davidpalma666/device.outputexpander-Fork/Hardware/PCB/output expander/harp expander output.kicad_pcb

## KiCad design Hardware/PCB/output expander/harp expander output.kicad_pcb (2026-06-30)

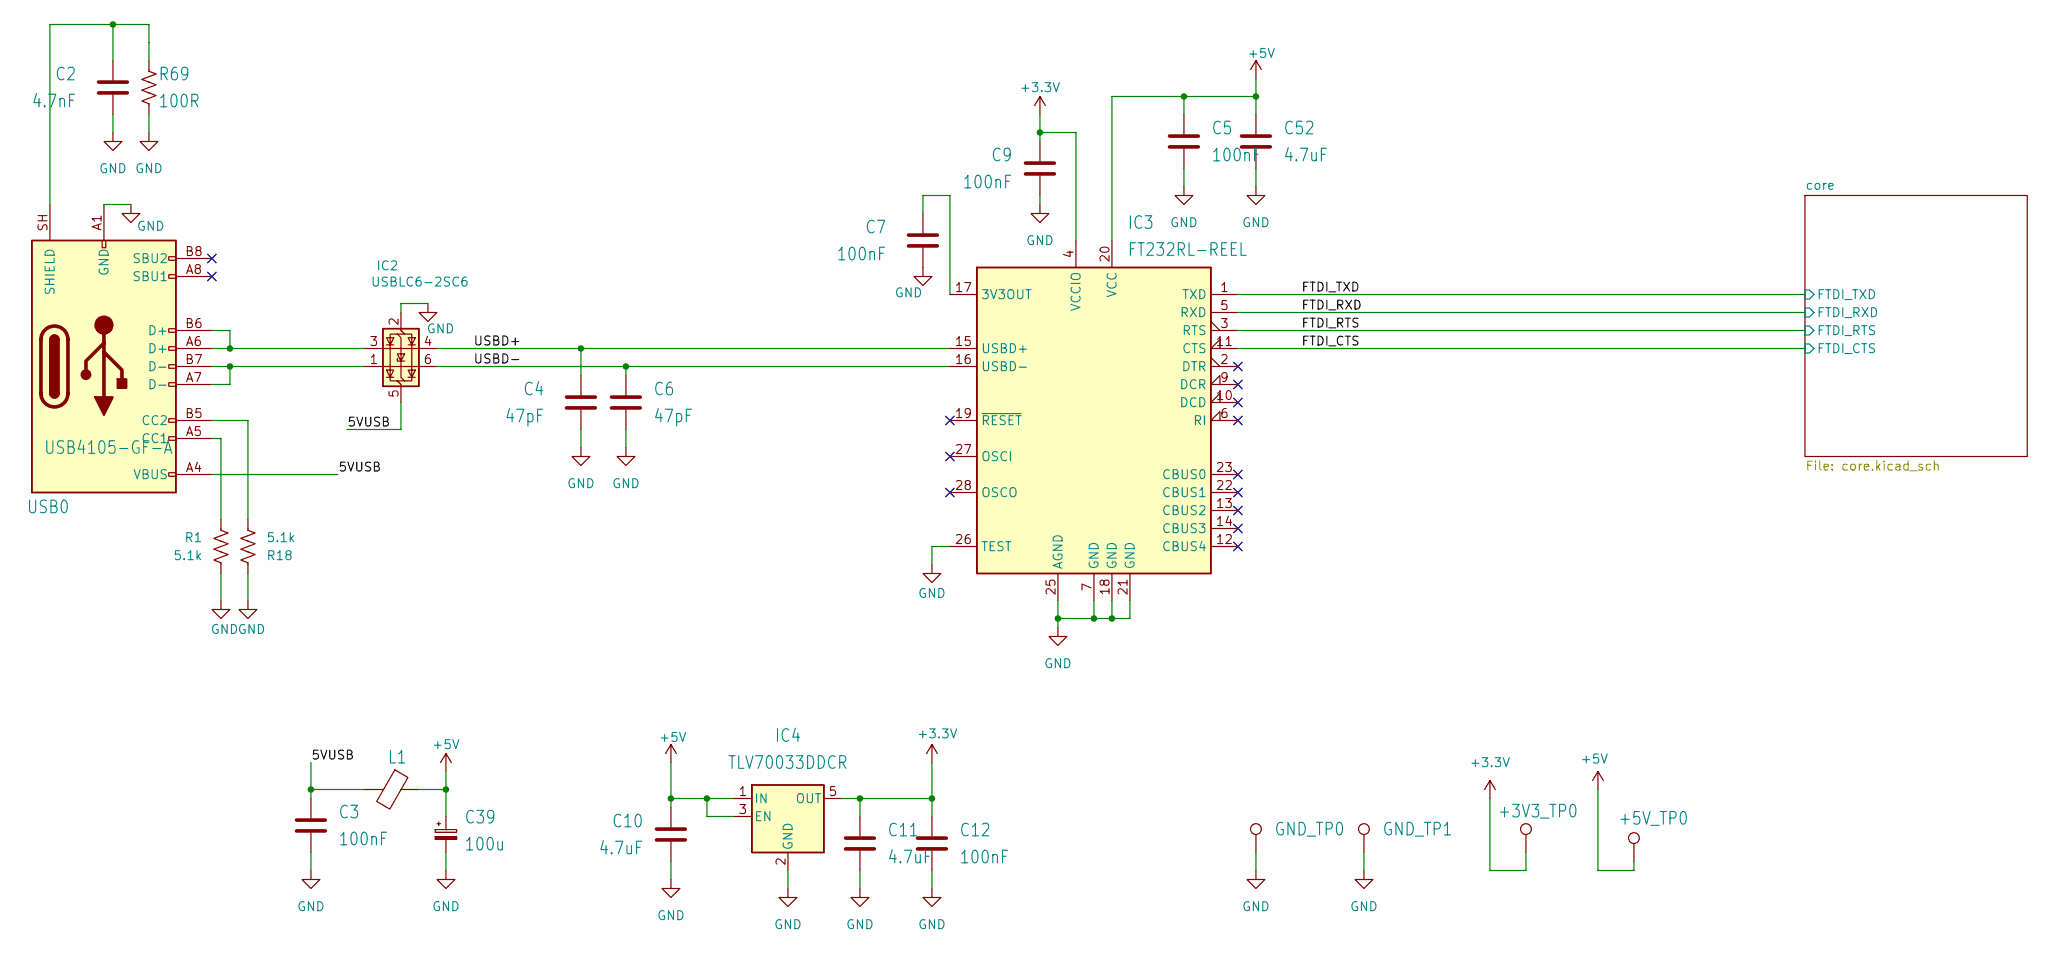
[picture p1: schematic harp expander output.kicad_sch]

Parts:
+3V3_TP0, +5V_TP0: TPPAD1-13; TestPoint_Loop_D1.80mm_Drill1.0mm_Beaded; MPN n.a.
C2: 4.7nF; C_0402_1005Metric; Tolerance 10%; Voltage 100V; MPN 885012205084
C3, C5, C7, C9, C12: 100nF; C_0402_1005Metric; Tolerance 10%; Voltage 50V; MPN CGA2B3X7R1H104K050BB
C4, C6: 47pF; C_0402_1005Metric; Tolerance 5%; Voltage 50V; MPN 04025A470JAT2A
C10, C11, C52: 4.7uF; C_0603_1608Metric; Tolerance 10%; Voltage 16V; MPN C1608X6S1C475K080AC
C39: 100u; CP_Radial_D6.3mm_P2.50mm; Tolerance 20%; Voltage 25V; MPN EEU-FM1E101B
GND_TP0, GND_TP1: TPPAD1-13; TestPoint_Loop_D1.80mm_Drill1.0mm_Beaded; MPN n.a.
IC2: USBLC6-2SC6; SOT-23-6; MPN USBLC6-2SC6
IC3: FT232RL-REEL; SSOP-28_5.3x10.2mm_P0.65mm; MPN FT232RL-REEL
IC4: TLV70033DDCR; SOT-23-5; MPN TLV70033DDCR
L1: MI0805K400R-10; R_0805_2012Metric; MPN MI0805K400R-10
R1, R18: 5.1k; R_0402_1005Metric; Tolerance 1%; MPN ERJ-2RKF5101X
R69: 100R; R_0603_1608Metric; Tolerance 1%; MPN CRCW0603100RFKEAHP
USB0: USB4105-GF-A; USB_C_Receptacle_GCT_USB4105-xx-A_16P_TopMnt_Horizontal; MPN USB4105-GF-A

Connections:
+3.3V: +3V3_TP0.1 (1_1), C9.1, C11.1, C12.1, IC3.4 (VCCIO), IC4.5 (OUT); also elsewhere on the board
+5V: +5V_TP0.1 (1_1), C5.1, C10.1, C39.1, C52.1, IC3.20 (VCC), IC4.1 (IN), IC4.3 (EN), L1.1; also elsewhere on the board
/5VUSB: C3.1, IC2.5 (VBUS), L1.2, USB0.A4 (VBUS), USB0.A9 (VBUS), USB0.B4 (VBUS), USB0.B9 (VBUS)
/FTDI_CTS: IC3.11 (CTS); also elsewhere on the board
/FTDI_RTS: IC3.3 (RTS); also elsewhere on the board
/FTDI_RXD: IC3.5 (RXD); also elsewhere on the board
/FTDI_TXD: IC3.1 (TXD); also elsewhere on the board
/USBD+: C4.1, IC2.4 (I/O2), IC3.15 (USBD+)
/USBD-: C6.1, IC2.6 (I/O1), IC3.16 (USBD-)
GND: C2.2, C3.2, C4.2, C5.2, C6.2, C7.2, C9.2, C10.2, C11.2, C12.2, C39.2, C52.2, GND_TP0.1 (1_1), GND_TP1.1 (1_1), IC2.2 (GND), IC3.7 (GND), IC3.18 (GND), IC3.21 (GND), IC3.25 (AGND), IC3.26 (TEST), IC4.2 (GND), R1.2, R18.1, R69.1, USB0.A1 (GND), USB0.A12 (GND), USB0.B1 (GND), USB0.B12 (GND); also elsewhere on the board
unnamed: IC2.1 (I/O1), USB0.A7 (D-), USB0.B7 (D-)
unnamed: IC2.3 (I/O2), USB0.A6 (D+), USB0.B6 (D+)
unnamed: C7.1, IC3.17 (3V3OUT)
unnamed: R1.1, USB0.A5 (CC1)
unnamed: R18.2, USB0.B5 (CC2)
unnamed: C2.1, R69.2, USB0.SH (SHIELD)

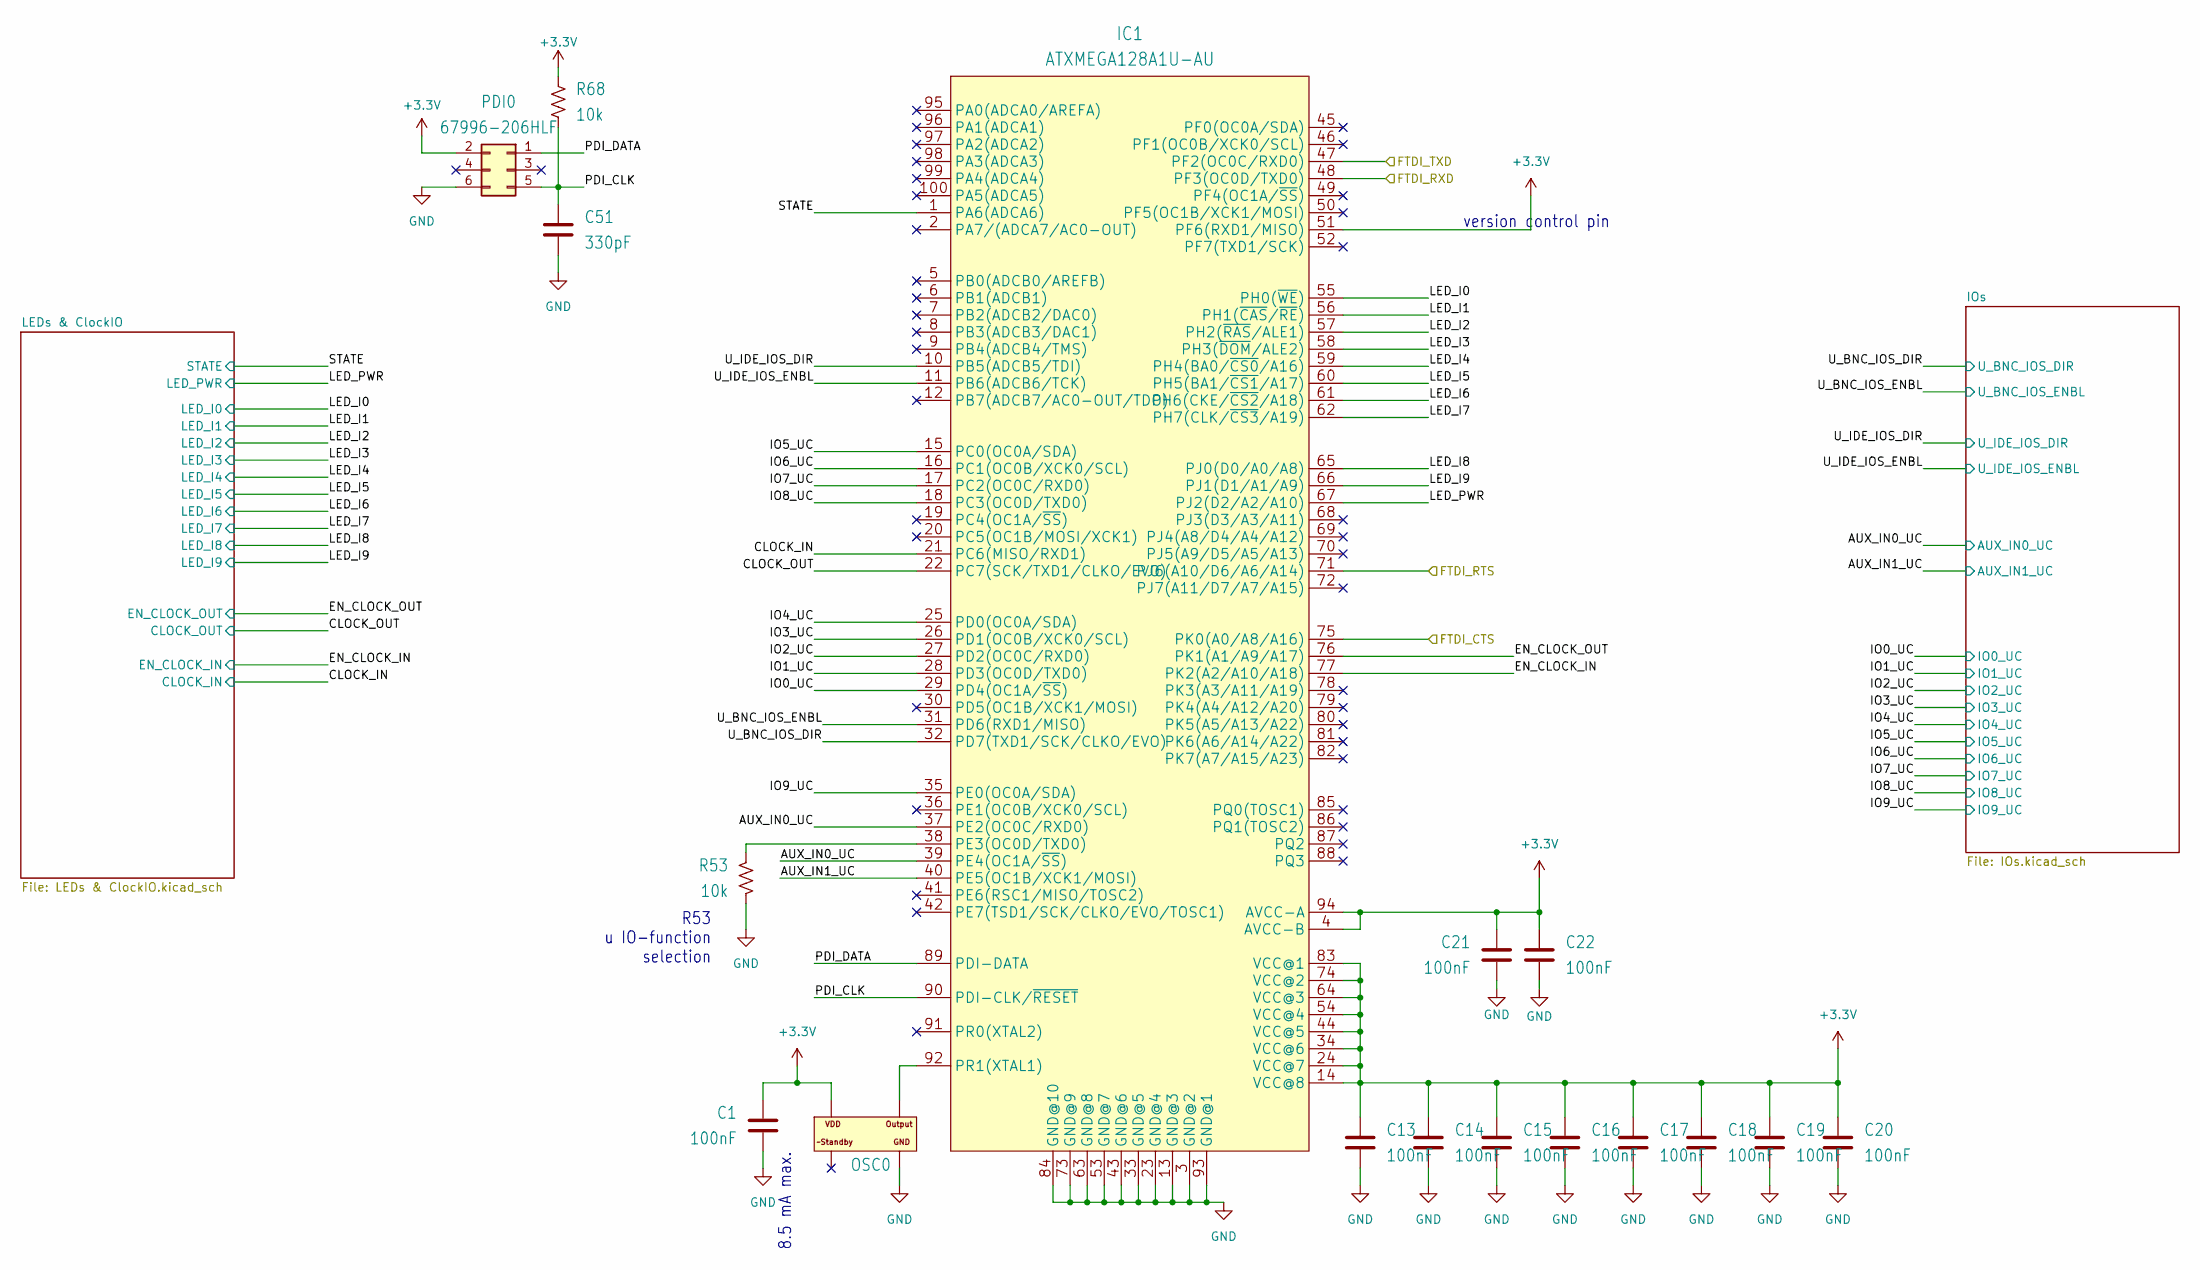
[picture p2: schematic core.kicad_sch]

Parts:
C1, C13, C14, C15, C16, C17, C18, C19, C20, C21, C22: 100nF; C_0402_1005Metric; Tolerance 10%; Voltage 50V; MPN CGA2B3X7R1H104K050BB
C51: 330pF; C_0402_1005Metric; Tolerance 5%; Voltage 50V; MPN C0402C331J5GAC7867
IC1: ATXMEGA128A1U-AU; TQFP-100_14x14mm_P0.5mm; MPN ATXMEGA128A1U-AU
OSC0: O 32,0-JT32C-A-K-3,3-LF; OSCILLATOR_3.2X2.5; MPN O 32,0-JT32C-A-K-3,3-LF
PDI0: 67996-206HLF; PinHeader_2x03_P2.54mm_Vertical; MPN 67996-206HLF
R53, R68: 10k; R_0402_1005Metric; Tolerance 1%; MPN CRCW040210K0FKED

Connections:
+3.3V: C1.1, C13.1, C14.1, C15.1, C16.1, C17.1, C18.1, C19.1, C20.1, C21.1, C22.1, IC1.4 (AVCC-B), IC1.14 (VCC@8), IC1.24 (VCC@7), IC1.34 (VCC@6), IC1.44 (VCC@5), IC1.51 (PF6(RXD1/MISO)), IC1.54 (VCC@4), IC1.64 (VCC@3), IC1.74 (VCC@2), IC1.83 (VCC@1), IC1.94 (AVCC-A), OSC0.4 (VDD), PDI0.2, R68.2; also elsewhere on the board
/FTDI_CTS: IC1.75 (PK0(A0/A8/A16)); also elsewhere on the board
/FTDI_RTS: IC1.71 (PJ6(A10/D6/A6/A14)); also elsewhere on the board
/FTDI_RXD: IC1.48 (PF3(OC0D/TXD0)); also elsewhere on the board
/FTDI_TXD: IC1.47 (PF2(OC0C/RXD0)); also elsewhere on the board
/core/AUX_IN0_UC: IC1.37 (PE2(OC0C/RXD0)), IC1.39 (PE4(OC1A/~SS)); also elsewhere on the board
/core/AUX_IN1_UC: IC1.40 (PE5(OC1B/XCK1/MOSI)); also elsewhere on the board
/core/CLOCK_IN: IC1.21 (PC6(MISO/RXD1)); also elsewhere on the board
/core/CLOCK_OUT: IC1.22 (PC7(SCK/TXD1/CLKO/EVO)); also elsewhere on the board
/core/EN_CLOCK_IN: IC1.77 (PK2(A2/A10/A18)); also elsewhere on the board
/core/EN_CLOCK_OUT: IC1.76 (PK1(A1/A9/A17)); also elsewhere on the board
/core/IO0_UC: IC1.29 (PD4(OC1A/~SS)); also elsewhere on the board
/core/IO1_UC: IC1.28 (PD3(OC0D/TXD0)); also elsewhere on the board
/core/IO2_UC: IC1.27 (PD2(OC0C/RXD0)); also elsewhere on the board
/core/IO3_UC: IC1.26 (PD1(OC0B/XCK0/SCL)); also elsewhere on the board
/core/IO4_UC: IC1.25 (PD0(OC0A/SDA)); also elsewhere on the board
/core/IO5_UC: IC1.15 (PC0(OC0A/SDA)); also elsewhere on the board
/core/IO6_UC: IC1.16 (PC1(OC0B/XCK0/SCL)); also elsewhere on the board
/core/IO7_UC: IC1.17 (PC2(OC0C/RXD0)); also elsewhere on the board
/core/IO8_UC: IC1.18 (PC3(OC0D/TXD0)); also elsewhere on the board
/core/IO9_UC: IC1.35 (PE0(OC0A/SDA)); also elsewhere on the board
/core/LED_I0: IC1.55 (PH0(~WE)); also elsewhere on the board
/core/LED_I1: IC1.56 (PH1(~CAS/~RE)); also elsewhere on the board
/core/LED_I2: IC1.57 (PH2(~RAS/ALE1)); also elsewhere on the board
/core/LED_I3: IC1.58 (PH3(~DOM/ALE2)); also elsewhere on the board
/core/LED_I4: IC1.59 (PH4(BA0/~CS0/A16)); also elsewhere on the board
/core/LED_I5: IC1.60 (PH5(BA1/~CS1/A17)); also elsewhere on the board
/core/LED_I6: IC1.61 (PH6(CKE/~CS2/A18)); also elsewhere on the board
/core/LED_I7: IC1.62 (PH7(CLK/~CS3/A19)); also elsewhere on the board
/core/LED_I8: IC1.65 (PJ0(D0/A0/A8)); also elsewhere on the board
/core/LED_I9: IC1.66 (PJ1(D1/A1/A9)); also elsewhere on the board
/core/LED_PWR: IC1.67 (PJ2(D2/A2/A10)); also elsewhere on the board
/core/PDI_CLK: C51.1, IC1.90 (PDI-CLK/~RESET), PDI0.5, R68.1
/core/PDI_DATA: IC1.89 (PDI-DATA), PDI0.1
/core/STATE: IC1.1 (PA6(ADCA6)); also elsewhere on the board
/core/U_BNC_IOS_DIR: IC1.32 (PD7(TXD1/SCK/CLKO/EVO)); also elsewhere on the board
/core/U_BNC_IOS_ENBL: IC1.31 (PD6(RXD1/MISO)); also elsewhere on the board
/core/U_IDE_IOS_DIR: IC1.10 (PB5(ADCB5/TDI)); also elsewhere on the board
/core/U_IDE_IOS_ENBL: IC1.11 (PB6(ADCB6/TCK)); also elsewhere on the board
GND: C1.2, C13.2, C14.2, C15.2, C16.2, C17.2, C18.2, C19.2, C20.2, C21.2, C22.2, C51.2, IC1.3 (GND@2), IC1.13 (GND@3), IC1.23 (GND@4), IC1.33 (GND@5), IC1.43 (GND@6), IC1.53 (GND@7), IC1.63 (GND@8), IC1.73 (GND@9), IC1.84 (GND@10), IC1.93 (GND@1), OSC0.2 (GND), PDI0.6, R53.2; also elsewhere on the board
unnamed: IC1.38 (PE3(OC0D/TXD0)), R53.1
unnamed: IC1.92 (PR1(XTAL1)), OSC0.3 (OUTPUT)

Notes on the sheet:
8.5 mA max.
R53 u IO-function selection
version control pin

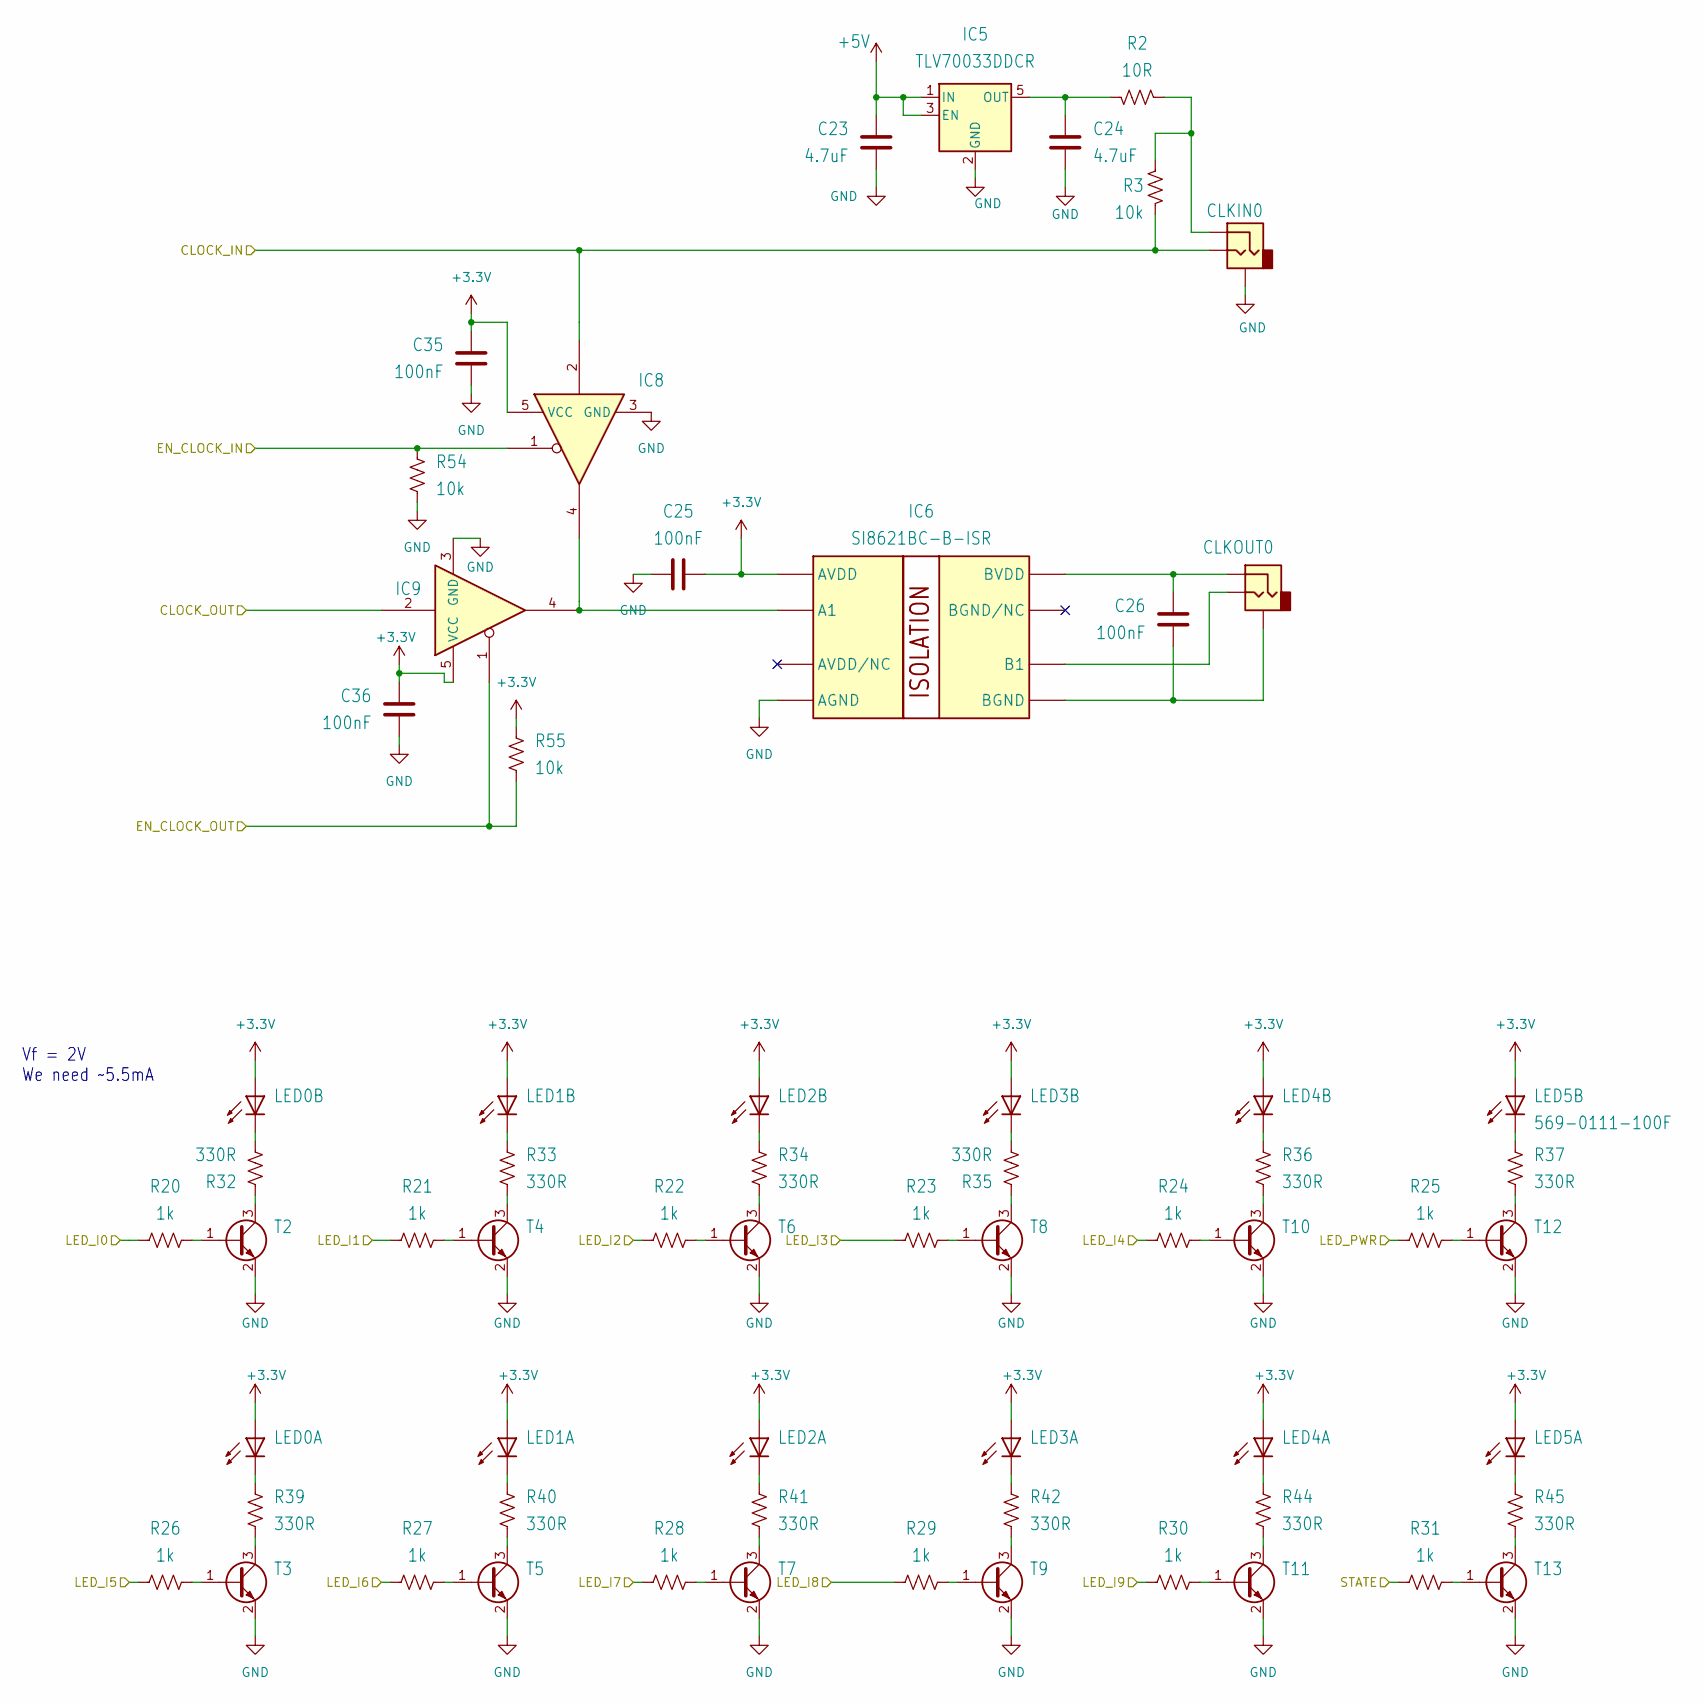
[picture p3: schematic LEDs & ClockIO.kicad_sch]

Parts:
C23, C24: 4.7uF; C_0603_1608Metric; Tolerance 10%; Voltage 16V; MPN C1608X6S1C475K080AC
C25, C26, C35, C36: 100nF; C_0402_1005Metric; Tolerance 10%; Voltage 50V; MPN CGA2B3X7R1H104K050BB
CLKIN0: 35RASMT2BHNTRX; MPN 35RASMT2BHNTRX
CLKOUT0: 35RASMT2BHNTRX; MPN 35RASMT2BHNTRX
IC5: TLV70033DDCR; SOT-23-5; MPN TLV70033DDCR
IC6: SI8621BC-B-ISR; SOIC-8_5.3x5.3mm_P1.27mm; MPN SI8621BC-B-ISR
IC8, IC9: SN74LVC1G125DBVT; SOT-23-5; MPN SN74LVC1G125DBVT
LED0, LED1, LED2, LED3, LED4, LED5: 569-0111-100F; 569-011X-X00_LED_ARRAY; MPN 569-0111-100F
R2: 10R; R_0402_1005Metric; Tolerance 5%; MPN ERJ-PA2J100X
R3, R54, R55: 10k; R_0402_1005Metric; Tolerance 1%; MPN CRCW040210K0FKED
R20, R21, R22, R23, R24, R25, R26, R27, R28, R29, R30, R31: 1k; R_0402_1005Metric; Tolerance 1%; MPN CRCW04021K00FKED
R32, R33, R34, R35, R36, R37, R39, R40, R41, R42, R44, R45: 330R; R_0402_1005Metric; Tolerance 1%; MPN RC0402FR-07330RL
T2, T3, T4, T5, T6, T7, T8, T9, T10, T11, T12, T13: BC850C,215; SOT-23; MPN BC850C,215

Connections:
+3.3V: C25.1, C35.1, C36.1, IC6.1 (AVDD), IC8.5 (VCC), IC9.5 (VCC), LED0.A1 (A), LED0.A2 (A), LED1.A1 (A), LED1.A2 (A), LED2.A1 (A), LED2.A2 (A), LED3.A1 (A), LED3.A2 (A), LED4.A1 (A), LED4.A2 (A), LED5.A1 (A), LED5.A2 (A), R55.2; also elsewhere on the board
+5V: C23.1, IC5.1 (IN), IC5.3 (EN); also elsewhere on the board
/core/CLOCK_IN: CLKIN0.2, IC8.2, R3.1; also elsewhere on the board
/core/CLOCK_OUT: IC9.2; also elsewhere on the board
/core/EN_CLOCK_IN: IC8.1, R54.1; also elsewhere on the board
/core/EN_CLOCK_OUT: IC9.1, R55.1; also elsewhere on the board
/core/LED_I0: R20.1; also elsewhere on the board
/core/LED_I1: R21.1; also elsewhere on the board
/core/LED_I2: R22.1; also elsewhere on the board
/core/LED_I3: R23.1; also elsewhere on the board
/core/LED_I4: R24.1; also elsewhere on the board
/core/LED_I5: R26.1; also elsewhere on the board
/core/LED_I6: R27.1; also elsewhere on the board
/core/LED_I7: R28.1; also elsewhere on the board
/core/LED_I8: R29.1; also elsewhere on the board
/core/LED_I9: R30.1; also elsewhere on the board
/core/LED_PWR: R25.1; also elsewhere on the board
/core/STATE: R31.1; also elsewhere on the board
GND: C23.2, C24.2, C25.2, C35.2, C36.2, CLKIN0.1, IC5.2 (GND), IC6.4 (AGND), IC8.3 (GND), IC9.3 (GND), R54.2, T2.2 (E), T3.2 (E), T4.2 (E), T5.2 (E), T6.2 (E), T7.2 (E), T8.2 (E), T9.2 (E), T10.2 (E), T11.2 (E), T12.2 (E), T13.2 (E); also elsewhere on the board
unnamed: CLKIN0.3, R2.1, R3.2
unnamed: C24.1, IC5.5 (OUT), R2.2
unnamed: IC6.2 (A1), IC8.4, IC9.4
unnamed: CLKOUT0.2, IC6.6 (B1)
unnamed: C26.2, CLKOUT0.1, IC6.5 (BGND)
unnamed: C26.1, CLKOUT0.3, IC6.8 (BVDD)
unnamed: LED0.C1 (C), R39.1
unnamed: LED0.C2 (C), R32.1
unnamed: LED1.C1 (C), R40.1
unnamed: LED1.C2 (C), R33.1
unnamed: LED2.C1 (C), R41.1
unnamed: LED2.C2 (C), R34.1
unnamed: LED3.C1 (C), R42.1
unnamed: LED3.C2 (C), R35.1
unnamed: LED4.C1 (C), R44.1
unnamed: LED4.C2 (C), R36.1
unnamed: LED5.C1 (C), R45.1
unnamed: LED5.C2 (C), R37.1
unnamed: R20.2, T2.1 (B)
unnamed: R32.2, T2.3 (C)
unnamed: R26.2, T3.1 (B)
unnamed: R39.2, T3.3 (C)
unnamed: R21.2, T4.1 (B)
unnamed: R33.2, T4.3 (C)
unnamed: R27.2, T5.1 (B)
unnamed: R40.2, T5.3 (C)
unnamed: R22.2, T6.1 (B)
unnamed: R34.2, T6.3 (C)
unnamed: R28.2, T7.1 (B)
unnamed: R41.2, T7.3 (C)
unnamed: R23.2, T8.1 (B)
unnamed: R35.2, T8.3 (C)
unnamed: R29.2, T9.1 (B)
unnamed: R42.2, T9.3 (C)
unnamed: R24.2, T10.1 (B)
unnamed: R36.2, T10.3 (C)
unnamed: R30.2, T11.1 (B)
unnamed: R44.2, T11.3 (C)
unnamed: R25.2, T12.1 (B)
unnamed: R37.2, T12.3 (C)
unnamed: R31.2, T13.1 (B)
unnamed: R45.2, T13.3 (C)

Notes on the sheet:
Vf = 2V We need ~5.5mA

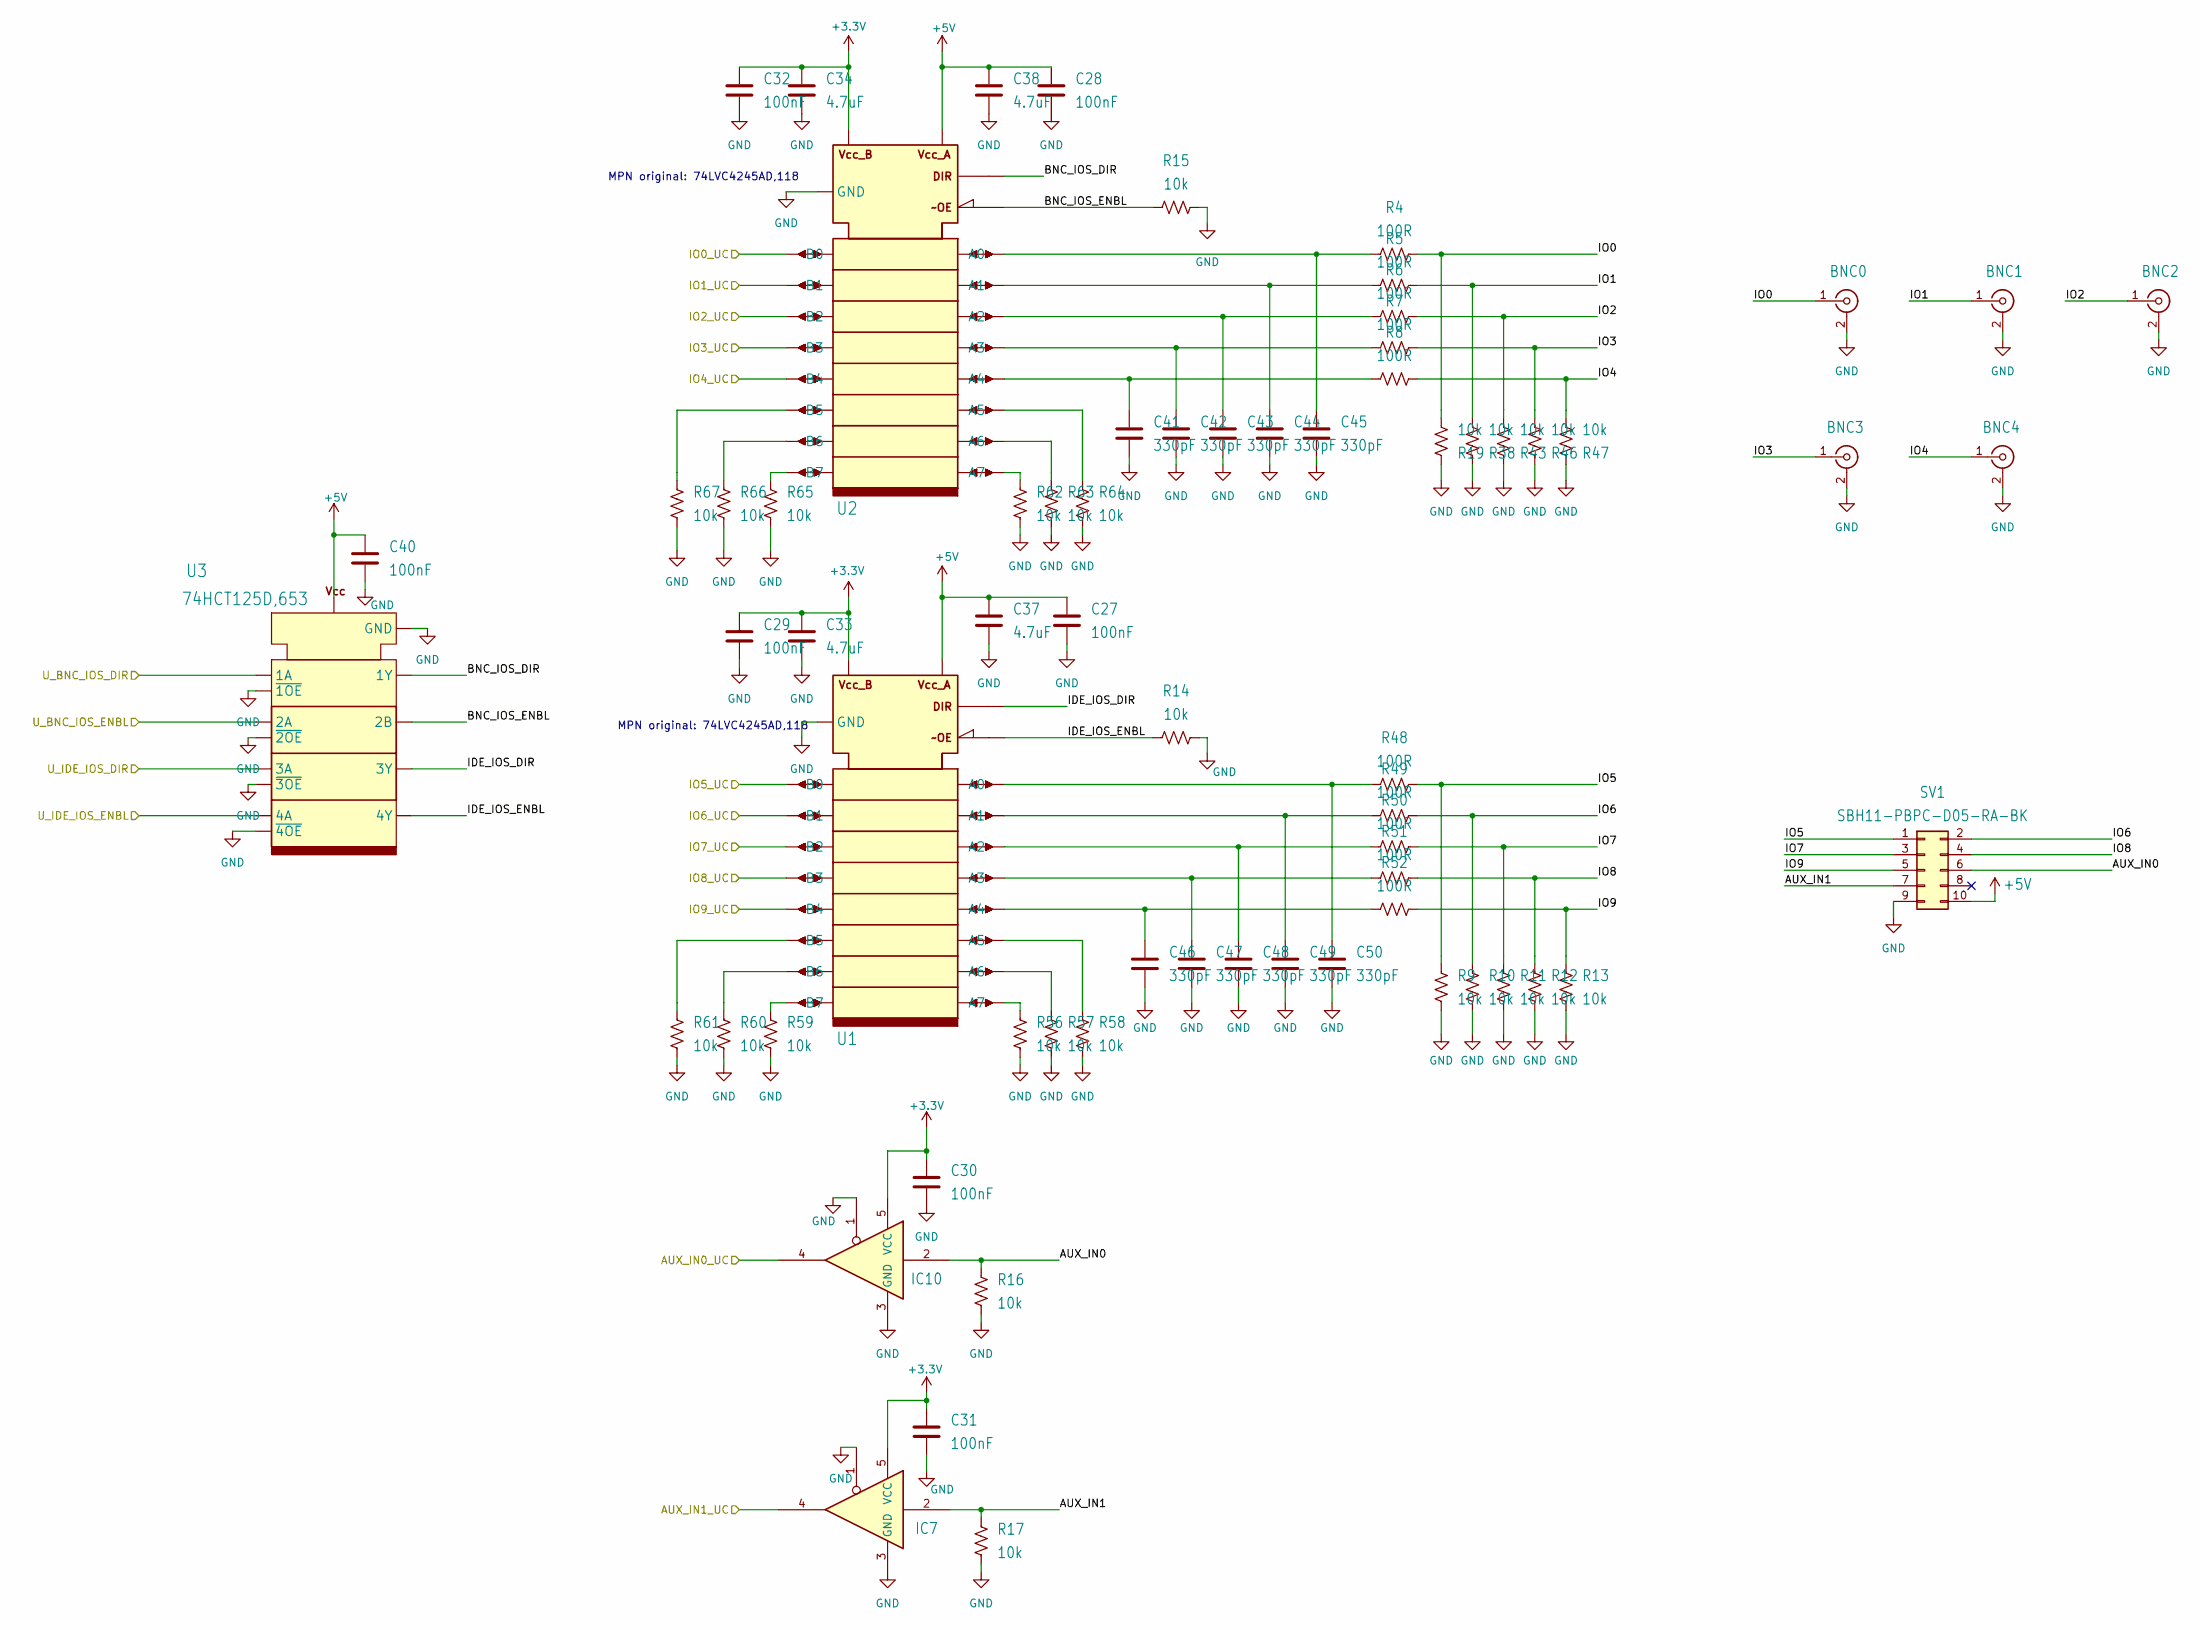
[picture p4: schematic IOs.kicad_sch, harp expander output]

Parts:
BNC0, BNC1, BNC2, BNC3, BNC4: 731000105; BNC_MOLEX_0731000105; MPN 731000105
C27, C28, C29, C30, C31, C32, C40: 100nF; C_0402_1005Metric; Tolerance 10%; Voltage 50V; MPN CGA2B3X7R1H104K050BB
C33, C34, C37, C38: 4.7uF; C_0603_1608Metric; Tolerance 10%; Voltage 16V; MPN C1608X6S1C475K080AC
C41, C42, C43, C44, C45, C46, C47, C48, C49, C50: 330pF; C_0402_1005Metric; Tolerance 5%; Voltage 50V; MPN C0402C331J5GAC7867
IC7, IC10: SN74LVC1G125DBVT; SOT-23-5; MPN SN74LVC1G125DBVT
R4, R5, R6, R7, R8, R48, R49, R50, R51, R52: 100R; R_0603_1608Metric; Tolerance 1%; MPN CRCW0603100RFKEAHP
R9, R10, R11, R12, R13, R14, R15, R16, R17, R19, R38, R43, R46, R47, R56, R57, R58, R59, R60, R61, R62, R63, R64, R65, R66, R67: 10k; R_0402_1005Metric; Tolerance 1%; MPN CRCW040210K0FKED
SV1: SBH11-PBPC-D05-RA-BK; IDC-Header_2x05_P2.54mm_Horizontal; MPN SBH11-PBPC-D05-RA-BK
U1, U2: SN74LVC4245APWR; SOIC-24W_7.5x15.4mm_P1.27mm; MPN SN74LVC4245APWR
U3: 74HCT125D,653; SO-14_5.3x10.2mm_P1.27mm; MPN 74HCT125D,653

Connections:
+3.3V: C29.1, C30.1, C31.1, C32.1, C33.1, C34.1, IC7.5 (VCC), IC10.5 (VCC), U1.23 (VCC_B), U1.24 (VCC_B), U2.23 (VCC_B), U2.24 (VCC_B); also elsewhere on the board
+5V: C27.1, C28.1, C37.1, C38.1, C40.1, SV1.10, U1.1 (VCC_A), U2.1 (VCC_A), U3.14 (VCC); also elsewhere on the board
/core/AUX_IN0_UC: IC10.4; also elsewhere on the board
/core/AUX_IN1_UC: IC7.4; also elsewhere on the board
/core/IO0_UC: U2.21 (B0); also elsewhere on the board
/core/IO1_UC: U2.20 (B1); also elsewhere on the board
/core/IO2_UC: U2.19 (B2); also elsewhere on the board
/core/IO3_UC: U2.18 (B3); also elsewhere on the board
/core/IO4_UC: U2.17 (B4); also elsewhere on the board
/core/IO5_UC: U1.21 (B0); also elsewhere on the board
/core/IO6_UC: U1.20 (B1); also elsewhere on the board
/core/IO7_UC: U1.19 (B2); also elsewhere on the board
/core/IO8_UC: U1.18 (B3); also elsewhere on the board
/core/IO9_UC: U1.17 (B4); also elsewhere on the board
/core/IOs/AUX_IN0: IC10.2, R16.1, SV1.6
/core/IOs/AUX_IN1: IC7.2, R17.1, SV1.7
/core/IOs/BNC_IOS_DIR: U2.2 (DIR), U3.3 (1Y)
/core/IOs/BNC_IOS_ENBL: R15.2, U2.22 (OE), U3.6 (2B)
/core/IOs/IDE_IOS_DIR: U1.2 (DIR), U3.8 (3Y)
/core/IOs/IDE_IOS_ENBL: R14.2, U1.22 (OE), U3.11 (4Y)
/core/IOs/IO0: BNC0.1 (In), R4.1, R19.2
/core/IOs/IO1: BNC1.1 (In), R5.1, R38.2
/core/IOs/IO2: BNC2.1 (In), R6.1, R43.2
/core/IOs/IO3: BNC3.1 (In), R7.1, R46.2
/core/IOs/IO4: BNC4.1 (In), R8.1, R47.2
/core/IOs/IO5: R9.1, R48.1, SV1.1
/core/IOs/IO6: R10.1, R49.1, SV1.2
/core/IOs/IO7: R11.1, R50.1, SV1.3
/core/IOs/IO8: R12.1, R51.1, SV1.4
/core/IOs/IO9: R13.1, R52.1, SV1.5
/core/U_BNC_IOS_DIR: U3.2 (1A); also elsewhere on the board
/core/U_BNC_IOS_ENBL: U3.5 (2A); also elsewhere on the board
/core/U_IDE_IOS_DIR: U3.9 (3A); also elsewhere on the board
/core/U_IDE_IOS_ENBL: U3.12 (4A); also elsewhere on the board
GND: BNC0.2 (Ext), BNC1.2 (Ext), BNC2.2 (Ext), BNC3.2 (Ext), BNC4.2 (Ext), C27.2, C28.2, C29.2, C30.2, C31.2, C32.2, C33.2, C34.2, C37.2, C38.2, C40.2, C41.2, C42.2, C43.2, C44.2, C45.2, C46.2, C47.2, C48.2, C49.2, C50.2, IC7.1, IC7.3 (GND), IC10.1, IC10.3 (GND), R9.2, R10.2, R11.2, R12.2, R13.2, R14.1, R15.1, R16.2, R17.2, R19.1, R38.1, R43.1, R46.1, R47.1, R56.2, R57.2, R58.2, R59.2, R60.2, R61.2, R62.2, R63.2, R64.2, R65.2, R66.2, R67.2, SV1.9, U1.11 (GND), U1.12 (GND), U1.13 (GND), U2.11 (GND), U2.12 (GND), U2.13 (GND), U3.1 (~1OE), U3.4 (~2OE), U3.7 (GND), U3.10 (~3OE), U3.13 (~4OE); also elsewhere on the board
unnamed: C50.1, R48.2, U1.3 (A0)
unnamed: C49.1, R49.2, U1.4 (A1)
unnamed: C48.1, R50.2, U1.5 (A2)
unnamed: C47.1, R51.2, U1.6 (A3)
unnamed: C46.1, R52.2, U1.7 (A4)
unnamed: R58.1, U1.8 (A5)
unnamed: R57.1, U1.9 (A6)
unnamed: R56.1, U1.10 (A7)
unnamed: R61.1, U1.16 (B5)
unnamed: R60.1, U1.15 (B6)
unnamed: R59.1, U1.14 (B7)
unnamed: C45.1, R4.2, U2.3 (A0)
unnamed: C44.1, R5.2, U2.4 (A1)
unnamed: C43.1, R6.2, U2.5 (A2)
unnamed: C42.1, R7.2, U2.6 (A3)
unnamed: C41.1, R8.2, U2.7 (A4)
unnamed: R64.1, U2.8 (A5)
unnamed: R63.1, U2.9 (A6)
unnamed: R62.1, U2.10 (A7)
unnamed: R67.1, U2.16 (B5)
unnamed: R66.1, U2.15 (B6)
unnamed: R65.1, U2.14 (B7)

Notes on the sheet:
MPN original: 74LVC4245AD,118

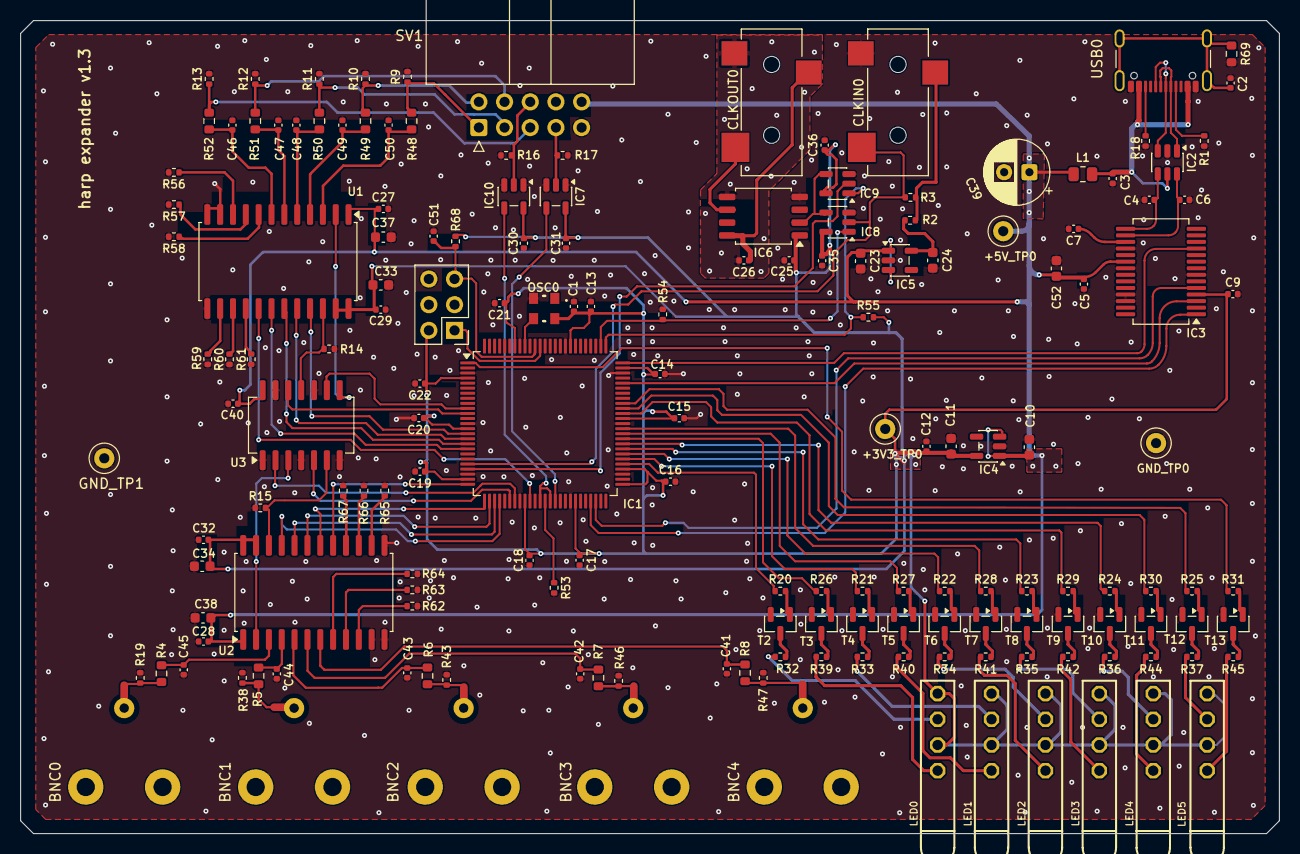
[picture p5: board harp expander output.kicad_pcb from above]

Board: 2 copper layers, 124.5 x 80.4 mm, 167 parts (0 on the bottom side), 132 nets.
