davidpalma666/device.outputexpander-Fork/(commit log)

2026-06-03 1º commit para revisão Filipe
    - estrtura de directorias modificada
    - front & rear panel já com ficheiros de produção
    - main board ainda sem ficheiros produção; dúvida sobre PN de U1 & U2 (ficheiro de notas)
    [IOs.kicad_sch, LEDs & ClockIO.kicad_sch, core.kicad_sch, harp expander BOM.xlsx, harp expander BOM_simplified.xlsx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]
2026-06-19 corrigida posição USB-C & gerados ficheiros de produção nos 3 projectos
    [LEDs & ClockIO.kicad_sch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]
2026-06-30 sync com main
    [IOs.kicad_sch, LEDs & ClockIO.kicad_sch, core.kicad_sch, harp expander output BOM.csv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]
